JoshuaMakuch/Spring-2024---ISU-Project/Pictures/Chroma_d ATV.png

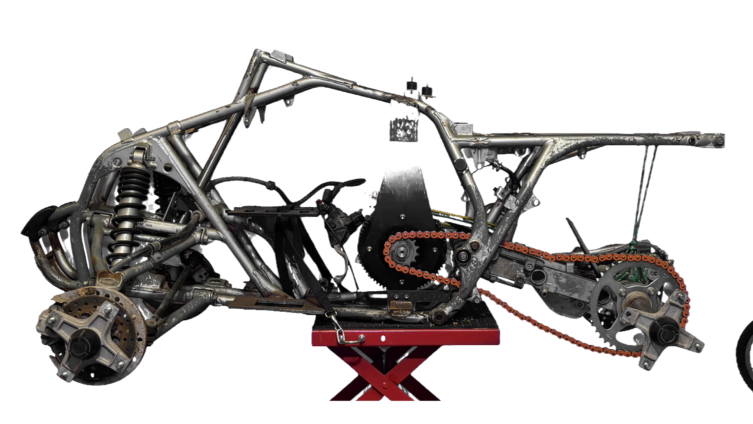
Pictures/Chroma_d ATV.png
