JoshuaMakuch/Spring-2024---ISU-Project/Pictures/IMG_2977.jpg

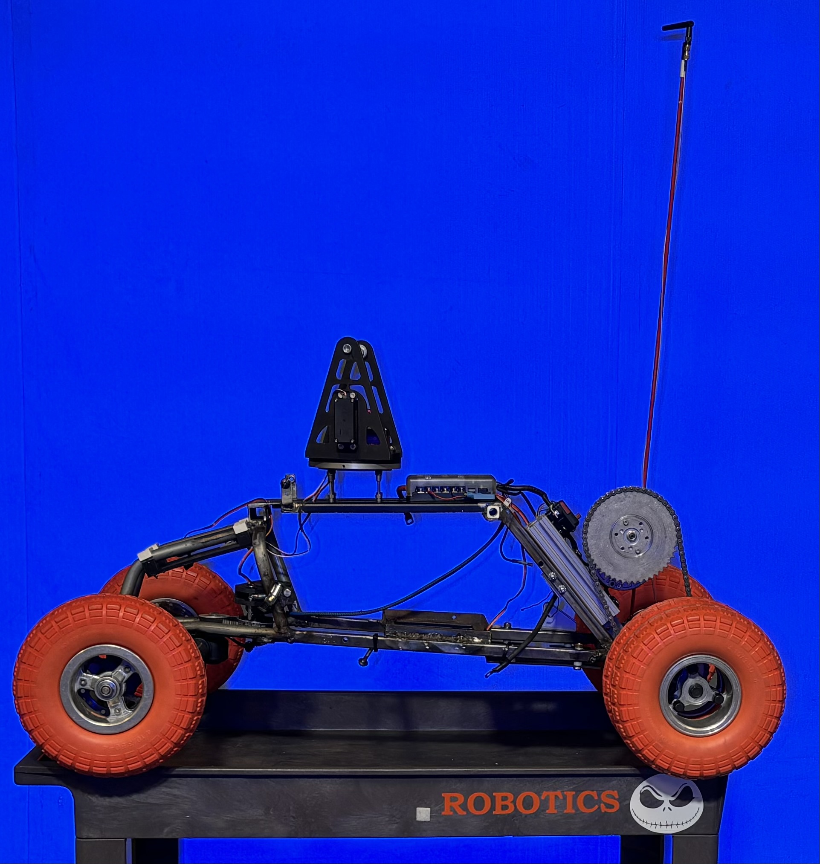
Pictures/IMG_2977.jpg
