JoshuaMakuch/Spring-2024---ISU-Project/ATV_TurretControl.X/nbproject/Makefile-genesis.properties.txt

#
#Wed Dec 06 12:36:48 MST 2023
default.Pack.dfplocation=C\:\\Program Files (x86)\\Microchip\\MPLABX\\v5.30\\packs\\Microchip\\PIC12-16F1xxx_DFP\\1.1.53
default.languagetoolchain.dir=C\:\\Program Files (x86)\\Microchip\\MPLABX\\v5.30\\mpasmx
configurations-xml=46c8e9170b4743dc52b52bbcd271e2ce
com-microchip-mplab-nbide-embedded-makeproject-MakeProject.md5=7cd2eead2ea6964989cbf02efe721a76
default.languagetoolchain.version=5.86
host.platform=windows
conf.ids=default
default.com-microchip-mplab-nbide-toolchainMPASMWIN-MPASMWINLanguageToolchain.md5=06bfb13b61b1022c5ad8ffc37ff26d14
