JoshuaMakuch/Spring-2024---ISU-Project/Spare Files/USB Bridge Driver.docx

https://www.silabs.com/developers/usb-to-uart-bridge-vcp-drivers?tab=downloads
