JoshuaMakuch/Spring-2024---ISU-Project/Pictures/Chroma_d miniATV.png

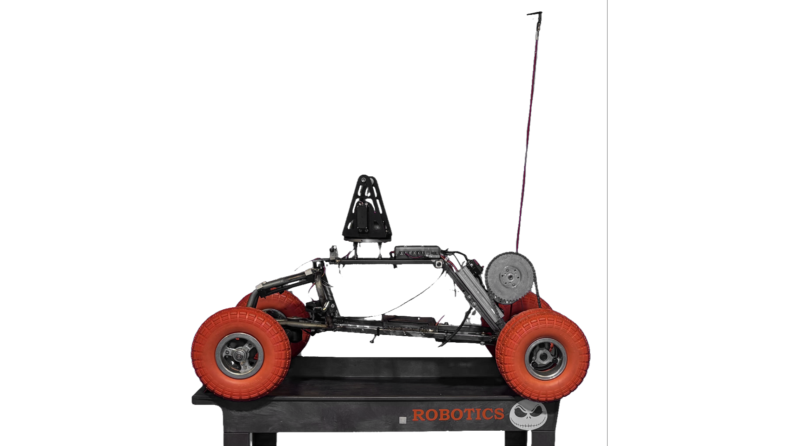
Pictures/Chroma_d miniATV.png
