JoshuaMakuch/Spring-2024---ISU-Project/Pictures/Chroma_d Turret.png

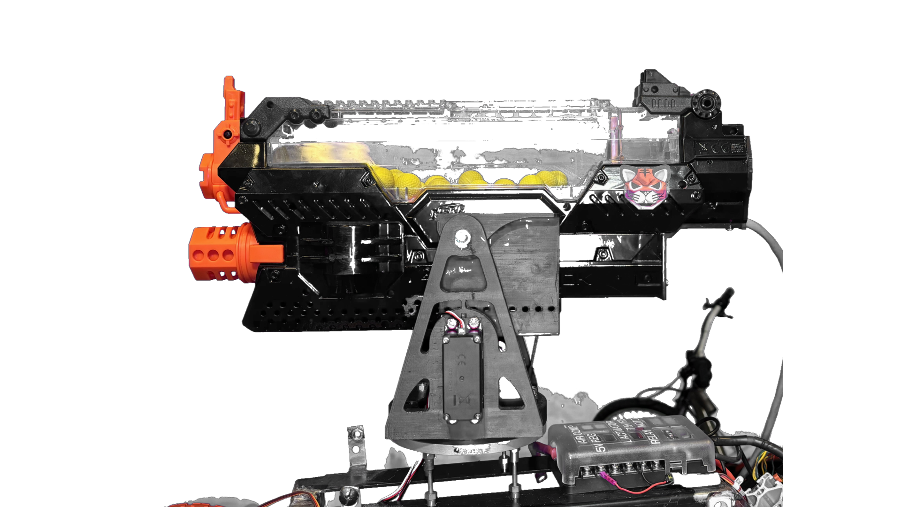
Pictures/Chroma_d Turret.png
