JoshuaMakuch/Spring-2024---ISU-Project/Pictures/IMG_2976.jpg

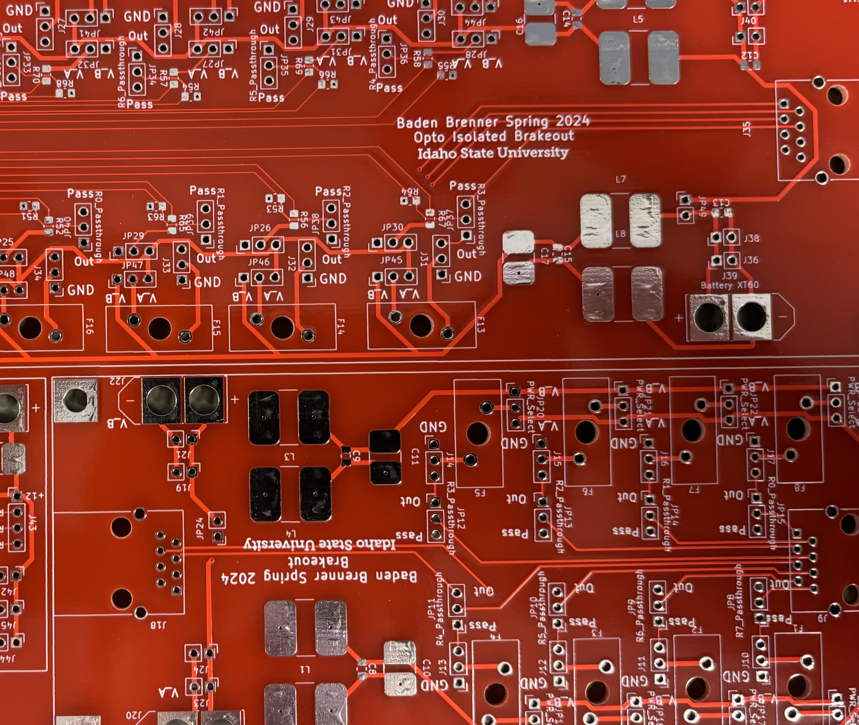
Pictures/IMG_2976.jpg
