JoshuaMakuch/Spring-2024---ISU-Project/Pictures/IMG_2980.jpg

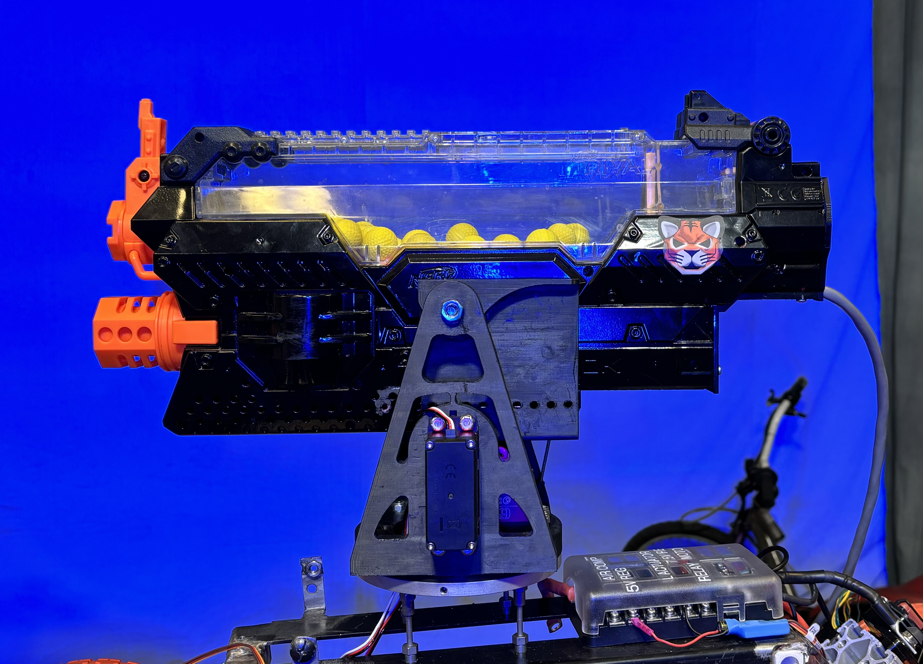
Pictures/IMG_2980.jpg
