JoshuaMakuch/Spring-2024---ISU-Project/Spare Files/20231208_123941.jpg

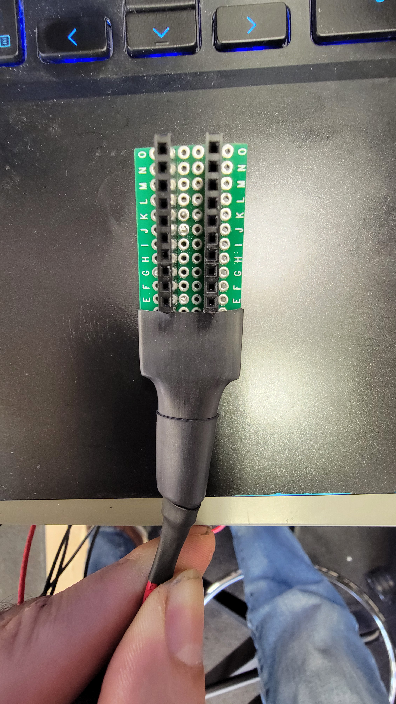
Spare Files/20231208_123941.jpg
