JoshuaMakuch/Spring-2024---ISU-Project/BOMs/ATV_Project_Slave_Board.xlsx

Reference | Value | Footprint | Manufatture Part # | Qty | 1x | 100x | Cost Per Bord
J1 | Program | Connector_PinHeader_2.54mm:PinHeader_1x05_P2.54mm_Vertical | TMS-103-02-G-S | 1 | $0.60 | $0.37 | 0.37
J8 | PWR IN | ATVProject_Library:2 Pin Header | TMS-103-02-G-S | 1 | $0.60 | $0.37 | 0.37
J10,J11,J12,J13,J14,J15,J16, J17,J27,J28,J29,J30,J31,J32, J33,J34 | 3PinHeader | ATVProject_Library:3 Pin Header | TMS-103-02-G-S | 16 | $0.60 | $0.37 | 5.92
J19,J21,J23,J24,J36,J38,J40, J41 | 2PinHeader | ATVProject_Library:2 Pin Header | TMS-103-02-G-S | 8 | $0.60 | $0.37 | 2.96
J20,J22,J37,J39,J47 | Battery XT60 | ATVProject_Library:XT60 | PRT-10474 | 5 | $1.50 | $1.50 | 7.5
U1 | PIC16F1788 | ATVProject_Library:PIC1788 | PIC16F1788-I/SS | 1 | $2.58 | $2.14 | 2.14
U2,U3 | ~ | ATVProject_Library:OptoCoupler (Quad) | PS2801C-4-A | 2 | $5.24 | $3.03 | 6.06
R47,R48,R49,R50,R51,R53, R54,R55,R59,R60,R61,R62, R63,R64,R66,R68,R71,R72, R73,R74,R75,R76,RN1 | 470 | -- mixed values -- | CR0805-JW-471ELF | 23 | $0.10 | $0.01 | 0.138
Q1,Q2,Q3,Q4,Q5,Q6 | IRF540N | Package_TO_SOT_THT:TO-220-3_Vertical | IRF540NPBF | 6 | $1.09 | $0.75 | 4.482
RN2 | R_Network08_US | Resistor_THT:R_Array_SIP9 | 4606X-AP2-103LF | 1 | $0.65 | $0.21 | 0.205
D3 | 1N4148 | Diode_SMD:D_0805_2012Metric_Pad1.15x1.40mm_HandSolder | 1N4148WS-HE3-18 | 1 | $0.23 | 0.067 | 0.067
C1,C4,C8,C9,C14,C15 | 1uF | Capacitor_SMD:C_0805_2012Metric_Pad1.18x1.45mm_HandSolder | 08051C104KAT4A | 6 | $0.11 | $0.04 | 0.234
C2,C3,C6,C7,C12,C13,C18 | 10uF | Capacitor_SMD:C_0805_2012Metric_Pad1.18x1.45mm_HandSolder | C0805C106M8PACTU | 7 | $0.24 | $0.08 | 0.532
C5 | 150uf | ATVProject_Library:2020 | EEF-KX0G151RF | 1 | $2.50 | $1.46 | 1.46
C10,C11,C16,C17,C19 | 150uF | ATVProject_Library:2020 | EEF-KX0G151RF | 5 | $2.50 | $1.46 | 7.3
D1,JP2 | SDA | -- mixed values -- | TMS-103-02-G-S | 2 | $0.60 | $0.37 | 0.74
D2,JP4 | SCL | -- mixed values -- | SM0805RC | 2 | $0.20 | $0.17 | 0.334
D4,D5,D6 | LED | Diode_SMD:D_0805_2012Metric_Pad1.15x1.40mm_HandSolder | SM0805RC | 3 | $0.20 | $0.17 | 0.501
D7,D15 | Debug 0 | Diode_SMD:D_0805_2012Metric_Pad1.15x1.40mm_HandSolder | SM0805RC | 2 | $0.20 | $0.17 | 0.334
D8,D16 | Debug 1 | Diode_SMD:D_0805_2012Metric_Pad1.15x1.40mm_HandSolder | SM0805RC | 2 | $0.20 | $0.17 | 0.334
D9,D17 | Debug 2 | Diode_SMD:D_0805_2012Metric_Pad1.15x1.40mm_HandSolder | SM0805RC | 2 | $0.20 | $0.17 | 0.334
D10,D18 | Debug 3 | Diode_SMD:D_0805_2012Metric_Pad1.15x1.40mm_HandSolder | SM0805RC | 2 | $0.20 | $0.17 | 0.334
D11,D19 | Debug 4 | Diode_SMD:D_0805_2012Metric_Pad1.15x1.40mm_HandSolder | SM0805RC | 2 | $0.20 | $0.17 | 0.334
D12,D20 | Debug 5 | Diode_SMD:D_0805_2012Metric_Pad1.15x1.40mm_HandSolder | SM0805RC | 2 | $0.20 | $0.17 | 0.334
D13,D21 | Debug 6 | Diode_SMD:D_0805_2012Metric_Pad1.15x1.40mm_HandSolder | SM0805RC | 2 | $0.20 | $0.17 | 0.334
D14,D22 | Debug 7 | Diode_SMD:D_0805_2012Metric_Pad1.15x1.40mm_HandSolder | SM0805RC | 2 | $0.20 | $0.17 | 0.334
F1,F2,F3,F4,F5,F6,F7,F8,F9, F10,F11,F12,F13,F14,F15, F16 | 5A | ATVProject_Library:Fuse Holder | 01530008Z | 16 | $4.08 | $2.65 | 42.4
J2,J5,J6,J9,J18,J25,J26,J35, J46 | RJ45_Shielded | -- mixed values -- | TMJUTVW0021192448 | 9 | $8.91 | $8.74 | 78.66
J3,J4,J7 | RJ9 | footprint library:RJ11_BB | 73306-111LF | 3 | $1.68 | $1.29 | 3.87
J42,J44,J45 | Conn_01x02 | ATVProject_Library:2 Pin Header | TMS-103-02-G-S | 3 | $0.60 | $0.37 | 1.11
J43 | Conn_01x04 | ATVProject_Library:4 Pin Header | TMS-103-02-G-S | 1 | $0.60 | $0.37 | 0.37
JP1,JP3,JP5,JP6 | Jumper_3_Bridged12 | ATVProject_Library:3 Pin Header | TMS-103-02-G-S | 4 | $0.60 | $0.37 | 1.48
JP7,JP24,JP49 | Jumper_2_Bridged | ATVProject_Library:2 Pin Header | TMS-103-02-G-S | 3 | $0.60 | $0.37 | 1.11
JP8,JP33 | R7_Passthrough | ATVProject_Library:3 Pin Header | TMS-103-02-G-S | 2 | $0.60 | $0.37 | 0.74
JP9,JP34 | R6_Passthrough | ATVProject_Library:3 Pin Header | TMS-103-02-G-S | 2 | $0.60 | $0.37 | 0.74
JP10,JP35 | R5_Passthrough | ATVProject_Library:3 Pin Header | TMS-103-02-G-S | 2 | $0.60 | $0.37 | 0.74
JP11,JP36 | R4_Passthrough | ATVProject_Library:3 Pin Header | TMS-103-02-G-S | 2 | $0.60 | $0.37 | 0.74
JP12,JP37 | R3_Passthrough | ATVProject_Library:3 Pin Header | TMS-103-02-G-S | 2 | $0.60 | $0.37 | 0.74
JP13,JP38 | R2_Passthrough | ATVProject_Library:3 Pin Header | TMS-103-02-G-S | 2 | $0.60 | $0.37 | 0.74
JP14,JP39 | R1_Passthrough | ATVProject_Library:3 Pin Header | TMS-103-02-G-S | 2 | $0.60 | $0.37 | 0.74
JP15,JP40 | R0_Passthrough | ATVProject_Library:3 Pin Header | TMS-103-02-G-S | 2 | $0.60 | $0.37 | 0.74
JP16,JP17,JP18,JP19,JP20, JP21,JP22,JP23,JP25,JP26, JP27,JP28,JP29,JP30,JP31, JP32,JP41,JP42,JP43,JP44, JP45,JP46,JP47,JP48 | PWR_Select | ATVProject_Library:3 Pin Header | TMS-103-02-G-S | 24 | $0.60 | $0.37 | 8.88
L1,L2,L3,L4,L5,L6,L7,L8 | 150uH | ATVProject_Library:3232 | SRR0735HA-151M | 8 | $1.58 | $0.95 | 7.616
R1,R2,R39,R45 | 4.7K | Resistor_SMD:R_0805_2012Metric_Pad1.20x1.40mm_HandSolder | CRCW08054K70FKEC | 4 | $0.11 | $0.02 | 0.088
R3,R4,R5,R6,R7,R8,R9,R10, R11,R13,R14,R15,R16,R17, R18,R19,R20,R21,R22,R23, R24,R25,R26,R27,R28,R29, R30,R31,R32,R33,R34,R35, R36,R37,R38,R40,R41,R42, R43,R44 | DNS | Resistor_SMD:R_0805_2012Metric_Pad1.20x1.40mm_HandSolder |  | 40
R12 | 10K | Resistor_SMD:R_0805_2012Metric_Pad1.20x1.40mm_HandSolder | CR0805-FX-1002ELF | 1 | $0.10 | $0.01 | 0.008
R46 | 2.2K | Resistor_SMD:R_0805_2012Metric_Pad1.20x1.40mm_HandSolder | CR0805-FX-2201ELF | 1 | $0.10 | $0.01 | 0.008
R52,R56,R57,R58,R65,R67, R69,R70 | 100 | Resistor_SMD:R_0805_2012Metric_Pad1.20x1.40mm_HandSolder | CR0805-JW-101ELF | 8 | $0.10 | $0.01 | 0.056
SW1 | SW_Slide_DPDT | ATVProject_Library:DPDT Switch | JS202011CQN | 1 | $0.64 | $0.48 | 0.48
 |  |  |  |  | Cost Per Board |  | $196.04
