JoshuaMakuch/Spring-2024---ISU-Project/Spare Files/Engineering Log.xlsx

Baden Brenner |  |  | Zachary Christensen |  |  | Joshua Makuch
Date | HRS | Task | Date | HRS | Task | Date | HRS | Task
2024-03-12 | 3 | Footprint/circuit design | 2024-03-12 | 3 | Footprints | 2024-03-12 | 3 | Gathering Parts/Coding
2024-03-15 | 3 | Footprint/circuit design | 2024-03-15 | 5 | Footprint Library Completion | 2024-03-15 | 3 | Gathering Parts/Coding
2024-03-25 | 4 | Footprint/circuit Board design | 2024-03-25 | 3 | Controller PCB layout and design | 2024-03-25 | 5 | Gathering Parts/Footprints
2024-03-26 | 4 | Footprint/circuit Board design | 2024-03-26 | 3 | Controller PCB design | 2024-03-26 | 4 | Coding/PCB Supervising
2024-03-27 | 5 | Footprint/circuit Board design | 2024-03-27 | 4.5 | Controller PCB Design | 2024-03-27 | 3 | Soldering Encoders
2024-03-28 | 5 | Footprint/circuit Board design | 2024-03-28 | 4 | Finish Contorller PCB Desing | 2024-03-28 | 3 | Schematic for Periph. Controller
2024-03-29 | 3 | Footprint/circuit Board design | 2024-03-29 | 3 | Update Controller PCB Layout | 2024-03-29 | 3 | Breadboarding Periph. Controller
2024-04-01 | 5 | Footprint/circuit Board design | 2024-04-01 | 3 | Fix I²C Trace Width | 2024-04-01 | 4 | Breadboarding Periph. Controller
2024-04-02 | 4 | Footprint/circuit Board design | 2024-04-02 | 3 | Begin CAD on Controller Case | 2024-04-02 | 5 | Coding Periph. Controller
2024-04-03 | 4 | Footprint/circuit Board design | 2024-04-03 | 3 | CAD Bottom Controller Case | 2024-04-03 | 2 | Coding Periph. Controller
2024-04-04 | 0 | --- | 2024-04-04 | 4 | CAD Top Controller Case | 2024-04-04 | 0 | ...
2024-04-05 | 0 | --- | 2024-04-05 | 5 | CAD Shoulder Buttons and stand offs | 2024-04-05 | 0 | ...
2024-04-08 | 3 | Coding Bot firmware | 2024-04-08 | 3 | CAD design updates | 2024-04-08 | 3 | Coding Main Controller
2024-04-09 | 3 | Footprint/circuit Board design | 2024-04-09 | 3 | Begin Plan on Large ATV | 2024-04-09 | 3 | Coding Main Controller
2024-04-10 | 4 | CAD/Turret design-Large ATV | 2024-04-10 | 3 | Large ATV planning and Dissassembly | 2024-04-10 | 3 | Establish I2C Two-Way Communication
2024-04-11 | 5 | CAD/Turret design-Large ATV | 2024-04-11 | 3 | Controller Case Design Adjustments | 2024-04-11 | 4 | Iron-Out I2C Two-Way Comms
2024-04-12 | 5 | CAD/Turret design-Large ATV | 2024-04-12 | 3 | Controller Case Add Logos | 2024-04-12 | 0 | ...
2024-04-15 | 3 | CAD/Turret design-Large ATV | 2024-04-15 | 3 | Controller Case Logos / Battery Box | 2024-04-15 | 3 | Begin work on I2C 2-way com protocol
2024-04-16 | 4 | design-Large ATV | 2024-04-16 | 3 | Controller Case Battery Box Design | 2024-04-16 | 4 | Troubleshoot I2C multi-byte 2-way coms
2024-04-17 | 5 | design-Large ATV | 2024-04-17 | 3 | Controller Battery Strap Design | 2024-04-17 | 4 | Fix I2C multi-byte 2-way coms
2024-04-18 | 4 | CAD/Turret design-Large ATV | 2024-04-18 | 3 | Shaft Coupler / Controller PCB BOM | 2024-04-18 | 3 | Establishing loss of peri. connection
2024-04-19 | 4 | CAD/Turret design-Large ATV | 2024-04-19 | 3 | Peripheral Mount / LCD Screen Case Design | 2024-04-19 | 3 | Troubleshooting loss of peri. connection
2024-04-22 | 3 | CAD/Start report | 2024-04-22 | 3 | Updating LCD screen case design | 2024-04-22 | 2 | Researching LCD Screen
2024-04-23 | 5 | Mechanical Drawings/Cannon assembly | 2024-04-23 | 3 | Mechanical Drawings | 2024-04-23 | 5 | Working on LCD screen
2024-04-24 | 4 | Solder Controller PCB | 2024-04-24 | 3 | Solder Controller PCB | 2024-04-24 | 4 | Finalizing Breadboard Design
2024-04-25 | 4 | Test PCB | 2024-04-25 | 3 | Solder Master board / Update Controller PCB | 2024-04-25 | 4 | Built Controller Prototype & Start Report
2024-04-26 | 3 | Report Planing | 2024-04-26 | 3 | Plan Report / Mechanical Drawings | 2024-04-26 | 2 | Writing Report
2024-04-27 | 6 | Project report | 2024-04-28 | 2 | Mechanical Drawings | 2024-04-27 | 5 | Writing report
2024-04-28 | 2 | Project report | 2024-04-29 | 7 | Report Write up | 2024-04-28 | 8 | Writing Report
2024-04-29 | 4 | Project report/Presentation | 2024-04-30 | 4 | Presentation and Report Write up | 2024-04-29 | 4 | Writing Report / Writing Presentation
2024-04-30 | 5 | Project report/Presentation |  |  |  | 2024-04-30 | 4 | Writing Report / Writing Presentation
Tortal hrs | 116 |  | Tortal hrs | 101.5 |  | Tortal hrs | 103
