JoshuaMakuch/Spring-2024---ISU-Project/ATV_Project_MasterBoard/ATV_Project_MasterBoard.kicad_pcb

## KiCad design ATV_Project_MasterBoard/ATV_Project_MasterBoard.kicad_pcb (2024-05-01)

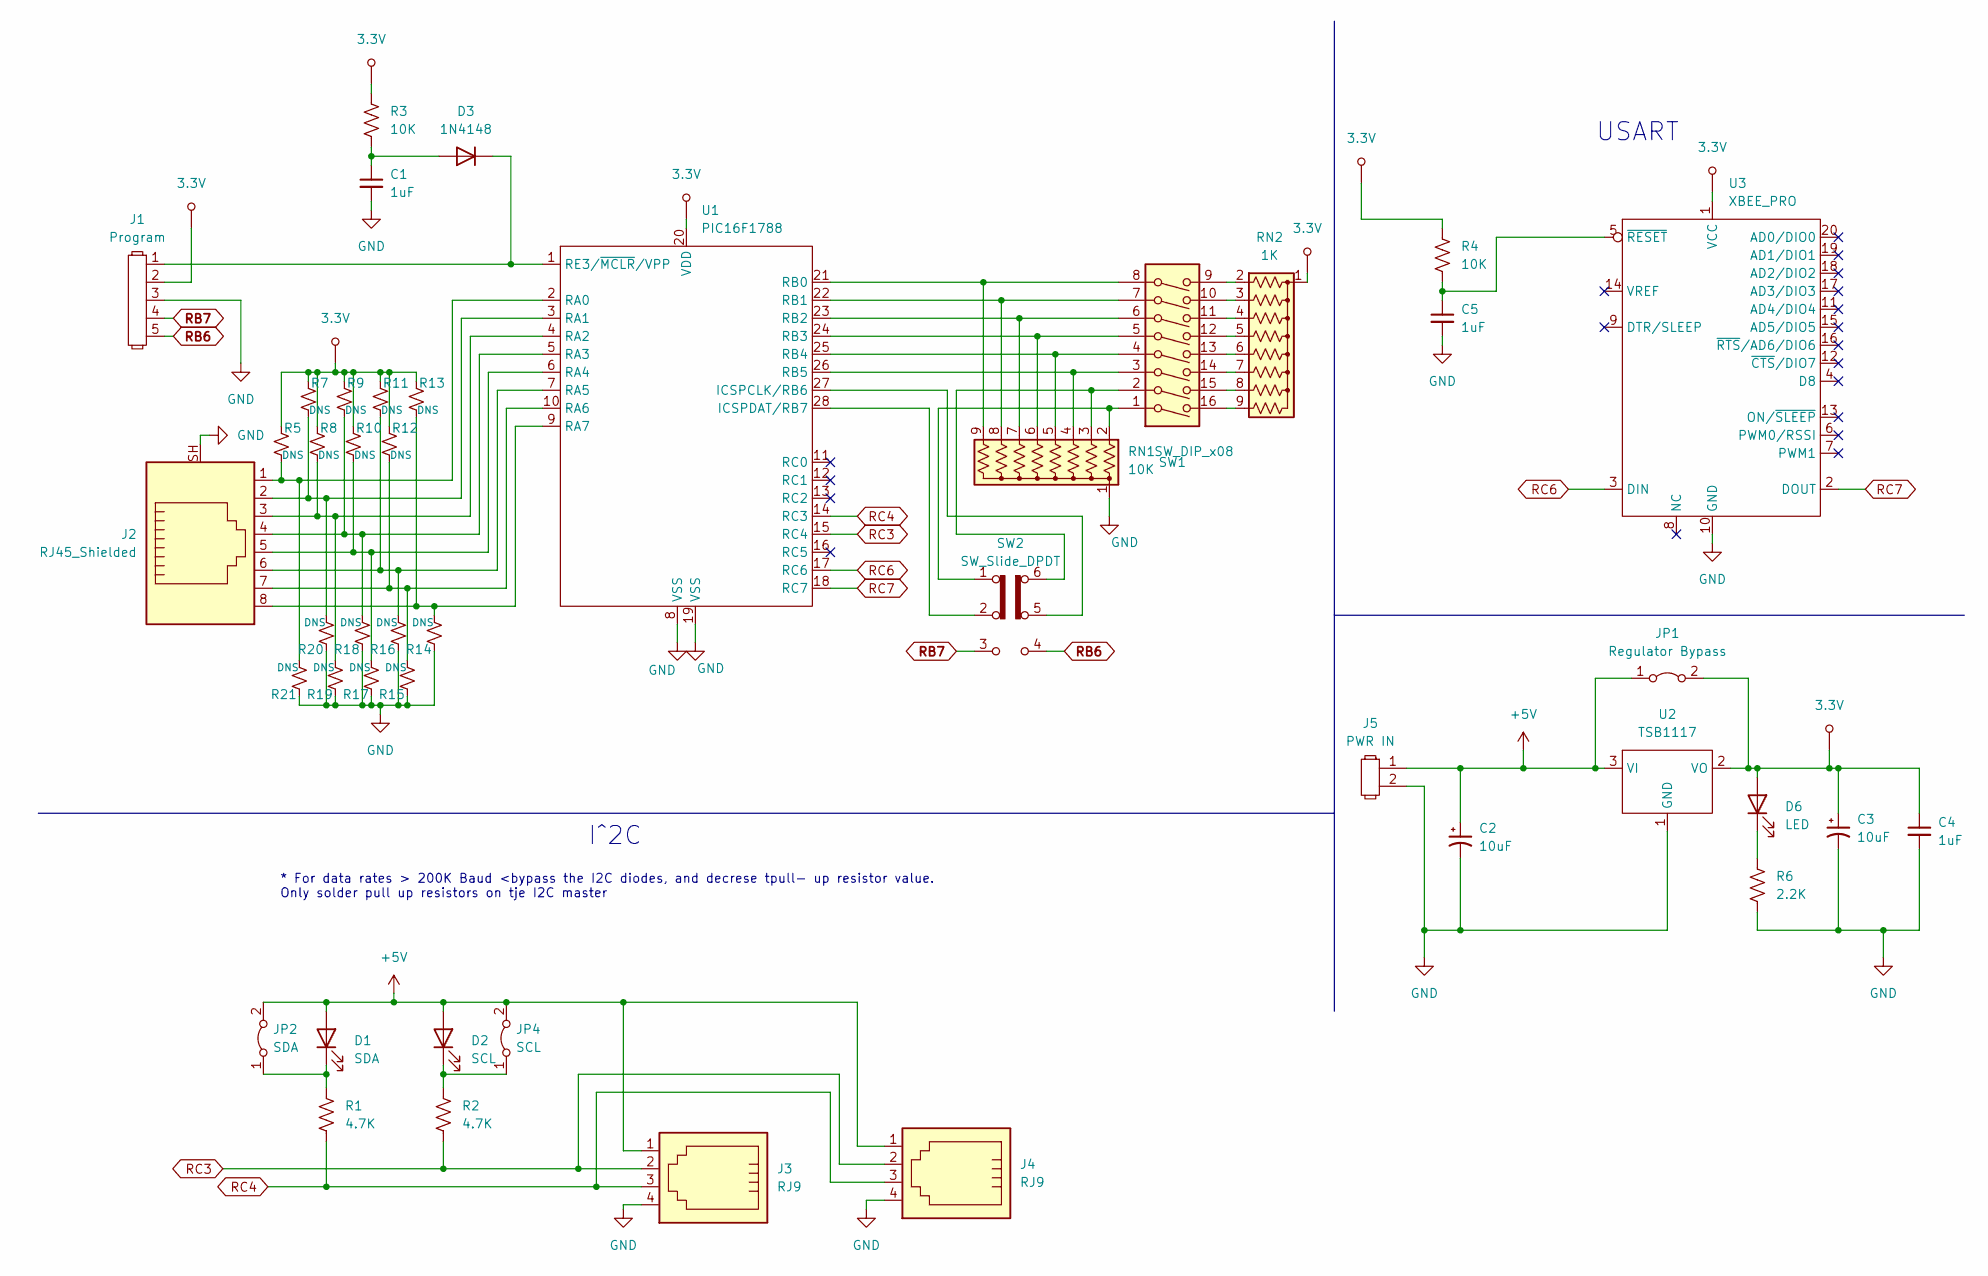
[picture p8: schematic ATV_Project_MasterBoard.kicad_sch]

Parts:
C1, C4, C5: 1uF; C_0805_2012Metric_Pad1.18x1.45mm_HandSolder
C2, C3: 10uF; C_0805_2012Metric_Pad1.18x1.45mm_HandSolder
D1: SDA; D_0805_2012Metric_Pad1.15x1.40mm_HandSolder
D2: SCL; D_0805_2012Metric_Pad1.15x1.40mm_HandSolder
D3: 1N4148; D_0805_2012Metric_Pad1.15x1.40mm_HandSolder
D6: LED; D_0805_2012Metric_Pad1.15x1.40mm_HandSolder
J1: Program; PinHeader_1x05_P2.54mm_Vertical
J2: RJ45_Shielded; RJ45_Shieleded_BB
J3, J4: RJ9; RJ11_BB
J5: PWR IN; 2 Pin Header
JP1: Regulator Bypass; PinHeader_1x02_P2.54mm_Vertical
JP2: SDA; PinHeader_1x02_P2.54mm_Vertical
JP4: SCL; PinHeader_1x02_P2.54mm_Vertical
R1, R2: 4.7K; R_0805_2012Metric_Pad1.20x1.40mm_HandSolder
R3, R4: 10K; R_0805_2012Metric_Pad1.20x1.40mm_HandSolder
R5, R7, R8, R9, R10, R11, R12, R13, R14, R15, R16, R17, R18, R19, R20, R21: DNS; R_0805_2012Metric_Pad1.20x1.40mm_HandSolder
R6: 2.2K; R_0805_2012Metric_Pad1.20x1.40mm_HandSolder
RN1: 10K; R_Array_SIP9
RN2: 1K; R_Array_SIP9
SW1: SW_DIP_x08; Dip Switch (16 pin)
SW2: SW_Slide_DPDT; DPDT Switch
U1: PIC16F1788; PIC1788
U2: TSB1117; SOT-223-3_TabPin2
U3: XBEE_PRO; Zigby

Connections:
3.3V: C3.1, C4.1, D6.2 (A), J1.2, JP1.2 (B), R3.1, R4.1, R5.1, R7.1, R8.1, R9.1, R10.1, R11.1, R12.1, R13.1, RN2.1 (common), U1.20 (VDD), U2.2 (VO), U3.1 (VCC)
+5V: C2.1, D1.2 (A), D2.2 (A), J3.1, J4.1, J5.1, JP1.1 (A), JP2.2 (B), JP4.2 (B), U2.3 (VI)
GND: C1.2, C2.2, C3.2, C4.2, C5.2, J1.3, J2.SH, J3.4, J4.4, J5.2, R6.2, R14.1, R15.1, R16.1, R17.1, R18.1, R19.1, R20.1, R21.1, RN1.1 (common), U1.8 (VSS), U1.19 (VSS), U2.1 (GND), U3.10 (GND)
unnamed: D1.1 (K), JP2.1 (A), R1.1
unnamed: D2.1 (K), JP4.1 (A), R2.1
unnamed: C1.1, D3.2 (A), R3.2
unnamed: D3.1 (K), J1.1, U1.1 (RE3/~MCLR/VPP)
unnamed: D6.1 (K), R6.1
unnamed: RN1.2 (R1), SW1.1, SW2.1 (A)
unnamed: RN1.3 (R2), SW1.2, SW2.6 (C)
unnamed: RN1.4 (R3), SW1.3, U1.26 (RB5)
unnamed: RN1.5 (R4), SW1.4, U1.25 (RB4)
unnamed: RN1.6 (R5), SW1.5, U1.24 (RB3)
unnamed: RN1.7 (R6), SW1.6, U1.23 (RB2)
unnamed: RN1.8 (R7), SW1.7, U1.22 (RB1)
unnamed: RN1.9 (R8), SW1.8, U1.21 (RB0)
unnamed: RN2.2 (R1), SW1.9
unnamed: RN2.3 (R2), SW1.10
unnamed: RN2.4 (R3), SW1.11
unnamed: RN2.5 (R4), SW1.12
unnamed: RN2.6 (R5), SW1.13
unnamed: RN2.7 (R6), SW1.14
unnamed: RN2.8 (R7), SW1.15
unnamed: RN2.9 (R8), SW1.16
unnamed: SW2.5 (B), U1.27 (ICSPCLK/RB6)
unnamed: SW2.2 (B), U1.28 (ICSPDAT/RB7)
unnamed: J2.1, R5.2, R21.2, U1.2 (RA0)
unnamed: J2.2, R7.2, R20.2, U1.3 (RA1)
unnamed: J2.3, R8.2, R19.2, U1.4 (RA2)
unnamed: J2.4, R9.2, R18.2, U1.5 (RA3)
unnamed: J2.5, R10.2, R17.2, U1.6 (RA4)
unnamed: J2.6, R11.2, R16.2, U1.7 (RA5)
unnamed: J2.7, R12.2, R15.2, U1.10 (RA6)
unnamed: J2.8, R13.2, R14.2, U1.9 (RA7)
unnamed: C5.1, R4.2, U3.5 (~RESET)
RB6: J1.5, SW2.4 (A)
RB7: J1.4, SW2.3 (C)
RC3: J3.2, J4.2, R2.2, U1.15 (RC4)
RC4: J3.3, J4.3, R1.2, U1.14 (RC3)
RC6: U1.17 (RC6), U3.3 (DIN)
RC7: U1.18 (RC7), U3.2 (DOUT)

Notes on the sheet:
USART
I^2C
* For data rates > 200K Baud <bypass the I2C diodes, and decrese tpull- up resistor value. Only solder pull up resistors on tje I2C master

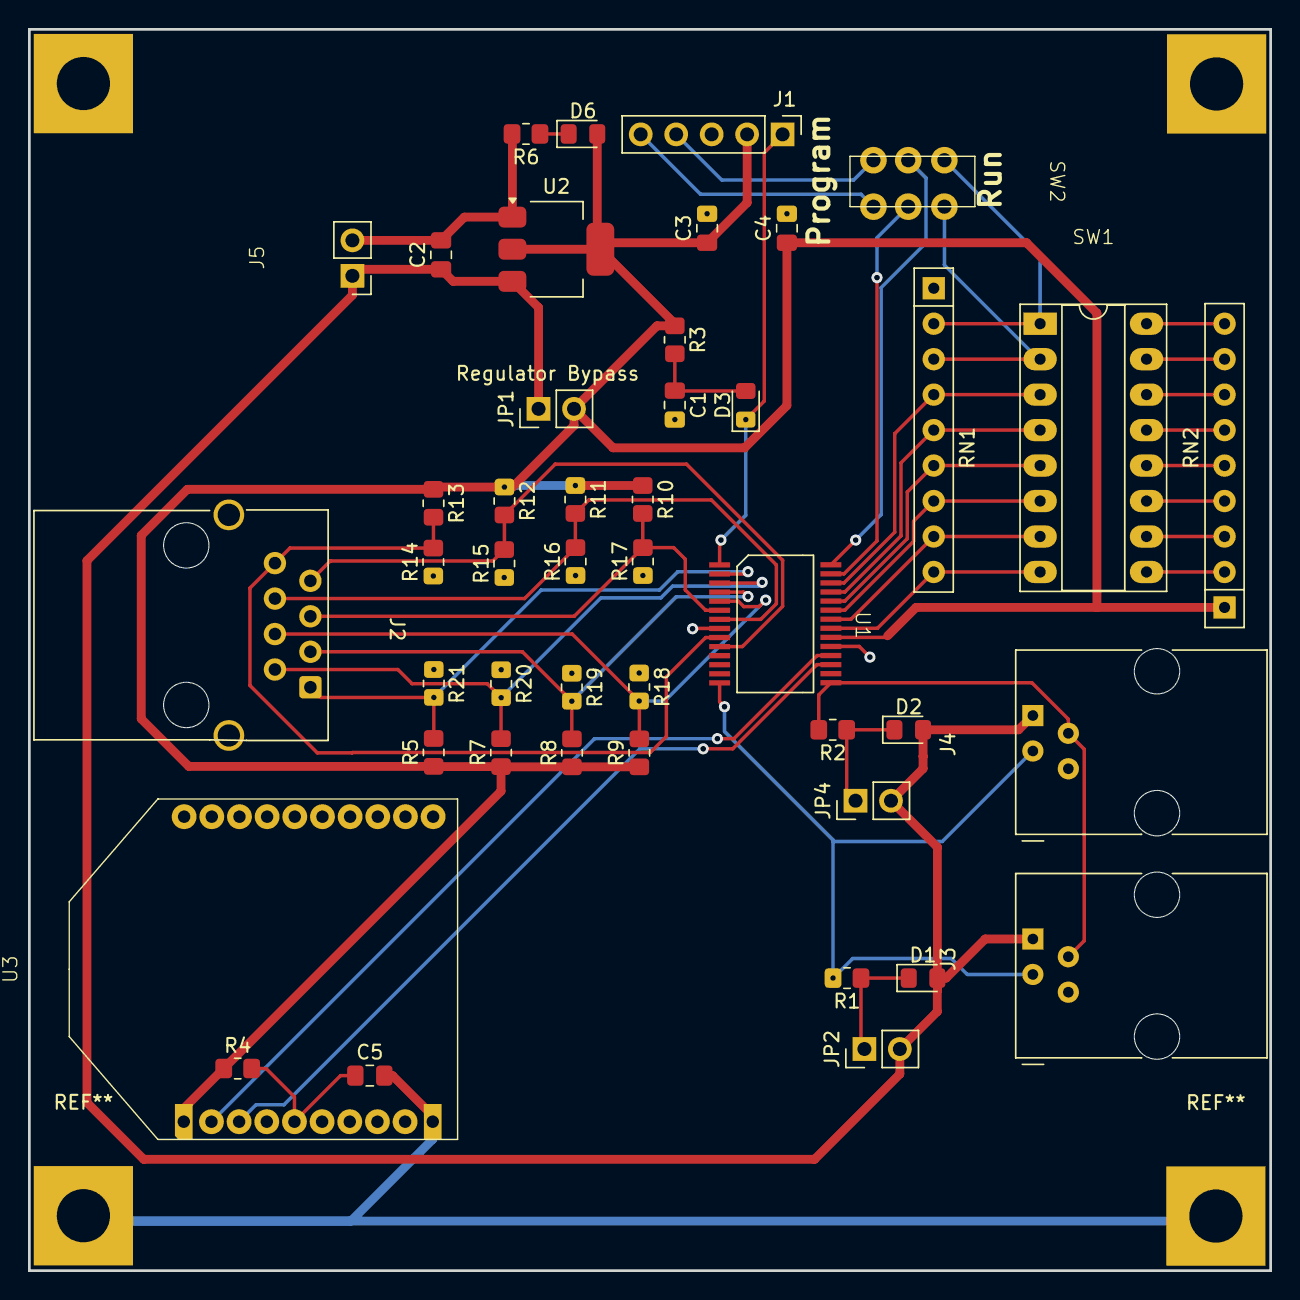
[picture p9: board ATV_Project_MasterBoard.kicad_pcb from above]

Board: 2 copper layers, 88.9 x 88.9 mm, 45 parts (0 on the bottom side), 41 nets.
