JoshuaMakuch/Spring-2024---ISU-Project/(commit log)

2024-05-01 ATV Footprint Library - 2023
2024-05-01 Spare Files
    [Engineering Log.xlsx, RCET Robot Remote Commands Development Fall 2023.xlsx]
2024-05-01 Code - ATV_Project_MasterBoard
    [ATV_Project_MasterBoard-B_Cu.gbr, ATV_Project_MasterBoard-B_Mask.gbr, ATV_Project_MasterBoard-B_Paste.gbr, ATV_Project_MasterBoard-B_Silkscreen.gbr, ATV_Project_MasterBoard-Edge_Cuts.gbr, ATV_Project_MasterBoard-F_Cu.gbr, ATV_Project_MasterBoard-F_Mask.gbr, ATV_Project_MasterBoard-F_Paste.gbr]
2024-05-01 ATV Slave Board
2024-05-01 KiCad - ATV_Slave_Project
    [ATV_Project_Slave Barg-B_Cu.gbr, ATV_Project_Slave Barg-B_Mask.gbr, ATV_Project_Slave Barg-B_Paste.gbr, ATV_Project_Slave Barg-B_Silkscreen.gbr, ATV_Project_Slave Barg-Edge_Cuts.gbr, ATV_Project_Slave Barg-F_Cu.gbr, ATV_Project_Slave Barg-F_Mask.gbr, ATV_Project_Slave Barg-F_Paste.gbr]
